joshnuss/accelerometer-watch/docs/Schematic.pdf

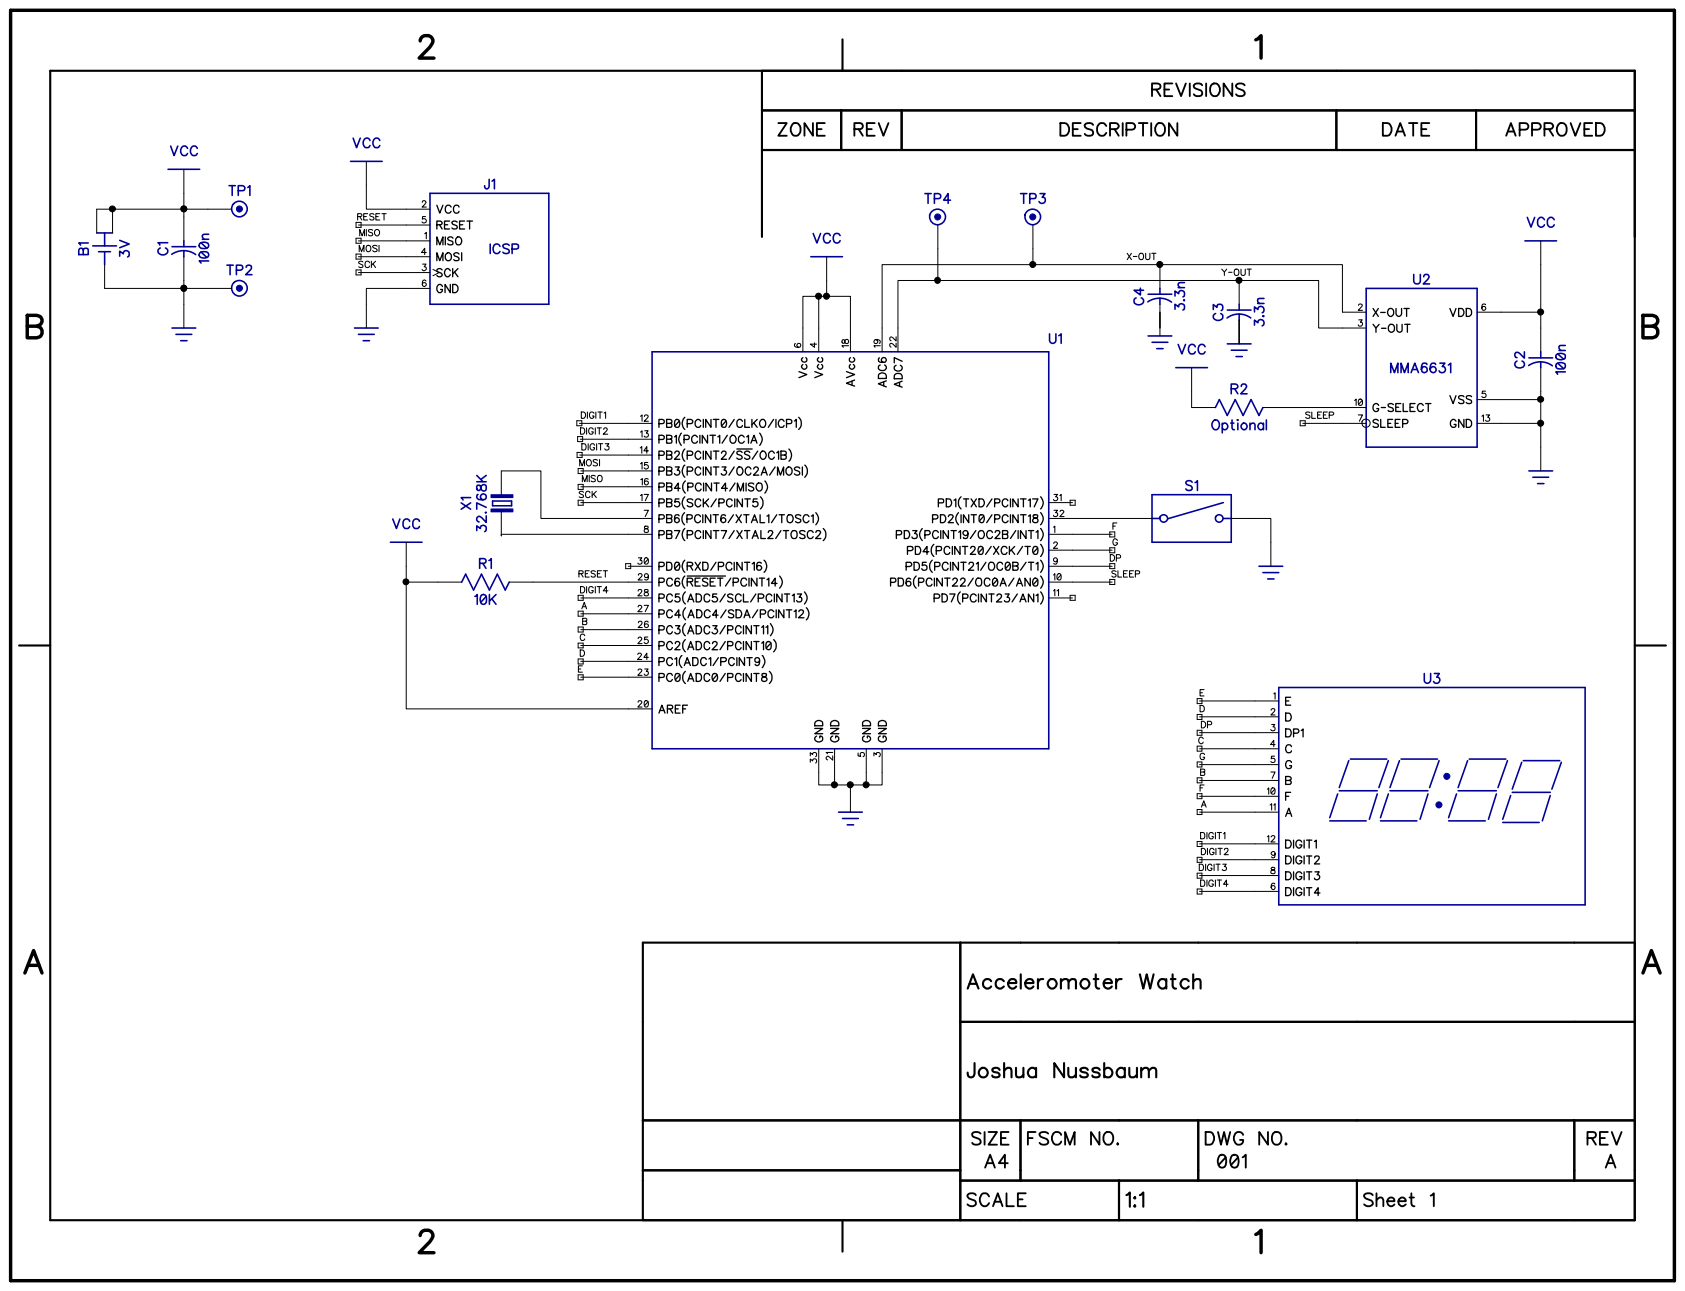
[picture p2: page 1]
