joshnuss/accelerometer-watch/docs/PCB.pdf

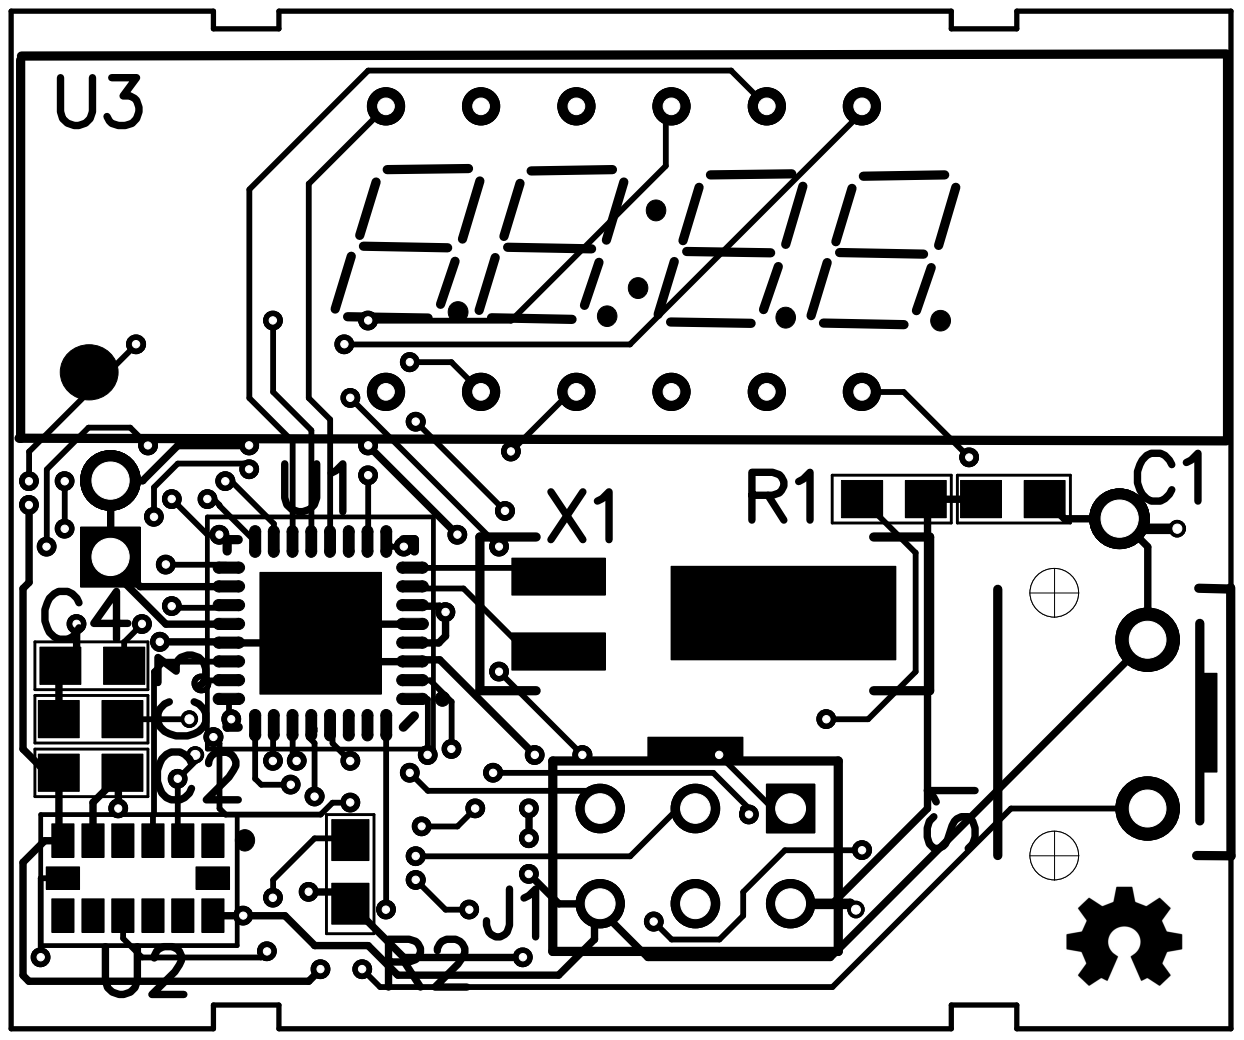
[picture p3: page 1]
