joshnuss/accelerometer-watch/(list of files, drawings)

Other design files:
docs/watch.dch
docs/watch.dip
