joshnuss/accelerometer-watch/(commit log)

2012-05-10 added schematic and pcb layout documentation
    [watch.dch, watch.dip]
2012-05-10 refactor makefile to allow setting fuses
2012-05-11 added bill of materials
    [bom.csv]
2012-05-11 fix diagram of segments
    [display.h]
2012-05-12 added program to test button interrupt
2012-05-12 refactor button code into button.h
2012-05-12 added accelerometer test program
2012-05-12 display point when sample is over 500
2012-05-12 refactor accelerometer code into accelerometer.h
2012-05-12 added clock firmware code, showing time when button is pressed
2012-05-12 added logic to debounce button
2012-05-12 tighten debounce time
2012-05-12 turn on watch when accelerometer is triggered
